GitRaka/ESD_Semester_Project/Schematics/PowerBoard/Buck-Boost Power Board/Project Outputs for Buck-Boost Power Board/PDF/DRC/Design Rules Check.PDF

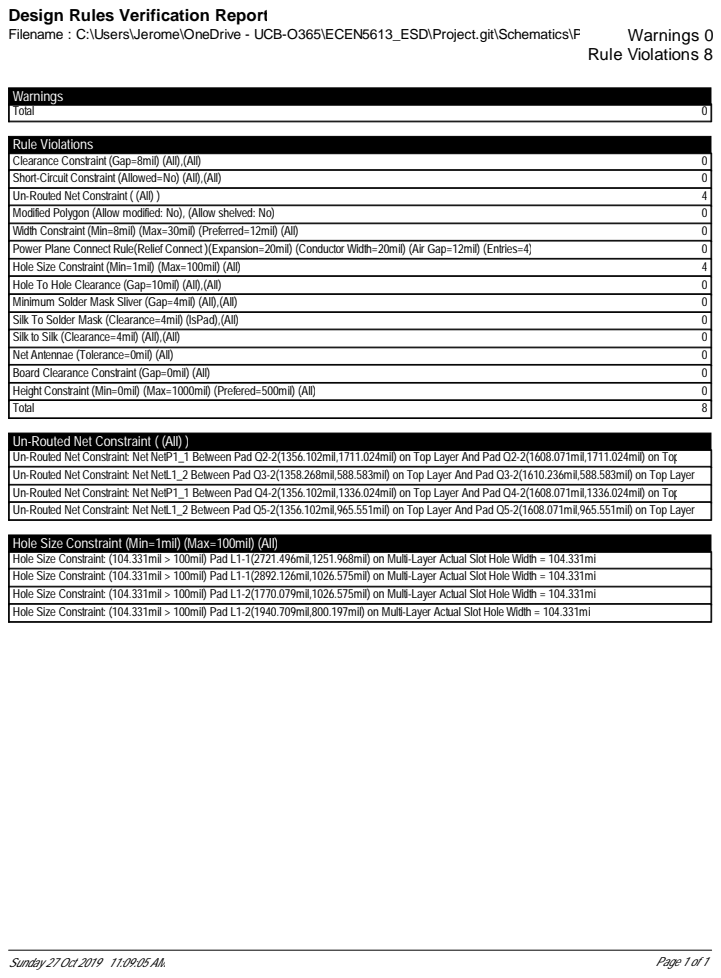
[picture p5: page 1]

Design Rules Verification Report

Un-Routed Net Constraint ( (All) )
Un-Routed Net Constraint: Net NetP1_1 Between Pad Q2-2(1356.102mil,1711.024mil) on Top Layer And Pad Q2-2(1608.071mil,1711.024mil) on Top
Un-Routed Net Constraint: Net NetL1_2 Between Pad Q3-2(1358.268mil,588.583mil) on Top Layer And Pad Q3-2(1610.236mil,588.583mil) on Top Layer
Un-Routed Net Constraint: Net NetP1_1 Between Pad Q4-2(1356.102mil,1336.024mil) on Top Layer And Pad Q4-2(1608.071mil,1336.024mil) on Top
Un-Routed Net Constraint: Net NetL1_2 Between Pad Q5-2(1356.102mil,965.551mil) on Top Layer And Pad Q5-2(1608.071mil,965.551mil) on Top Layer

Hole Size Constraint (Min=1mil) (Max=100mil) (All)
Hole Size Constraint: (104.331mil > 100mil) Pad L1-1(2721.496mil,1251.968mil) on Multi-Layer Actual Slot Hole Width = 104.331mi
Hole Size Constraint: (104.331mil > 100mil) Pad L1-1(2892.126mil,1026.575mil) on Multi-Layer Actual Slot Hole Width = 104.331mi
Hole Size Constraint: (104.331mil > 100mil) Pad L1-2(1770.079mil,1026.575mil) on Multi-Layer Actual Slot Hole Width = 104.331mi
Hole Size Constraint: (104.331mil > 100mil) Pad L1-2(1940.709mil,800.197mil) on Multi-Layer Actual Slot Hole Width = 104.331mi
