GitRaka/ESD_Semester_Project/Schematics/PowerBoard/Buck-Boost Power Board/Project Outputs for Buck-Boost Power Board/PDF/Schematic Print/Schematic Prints.PDF

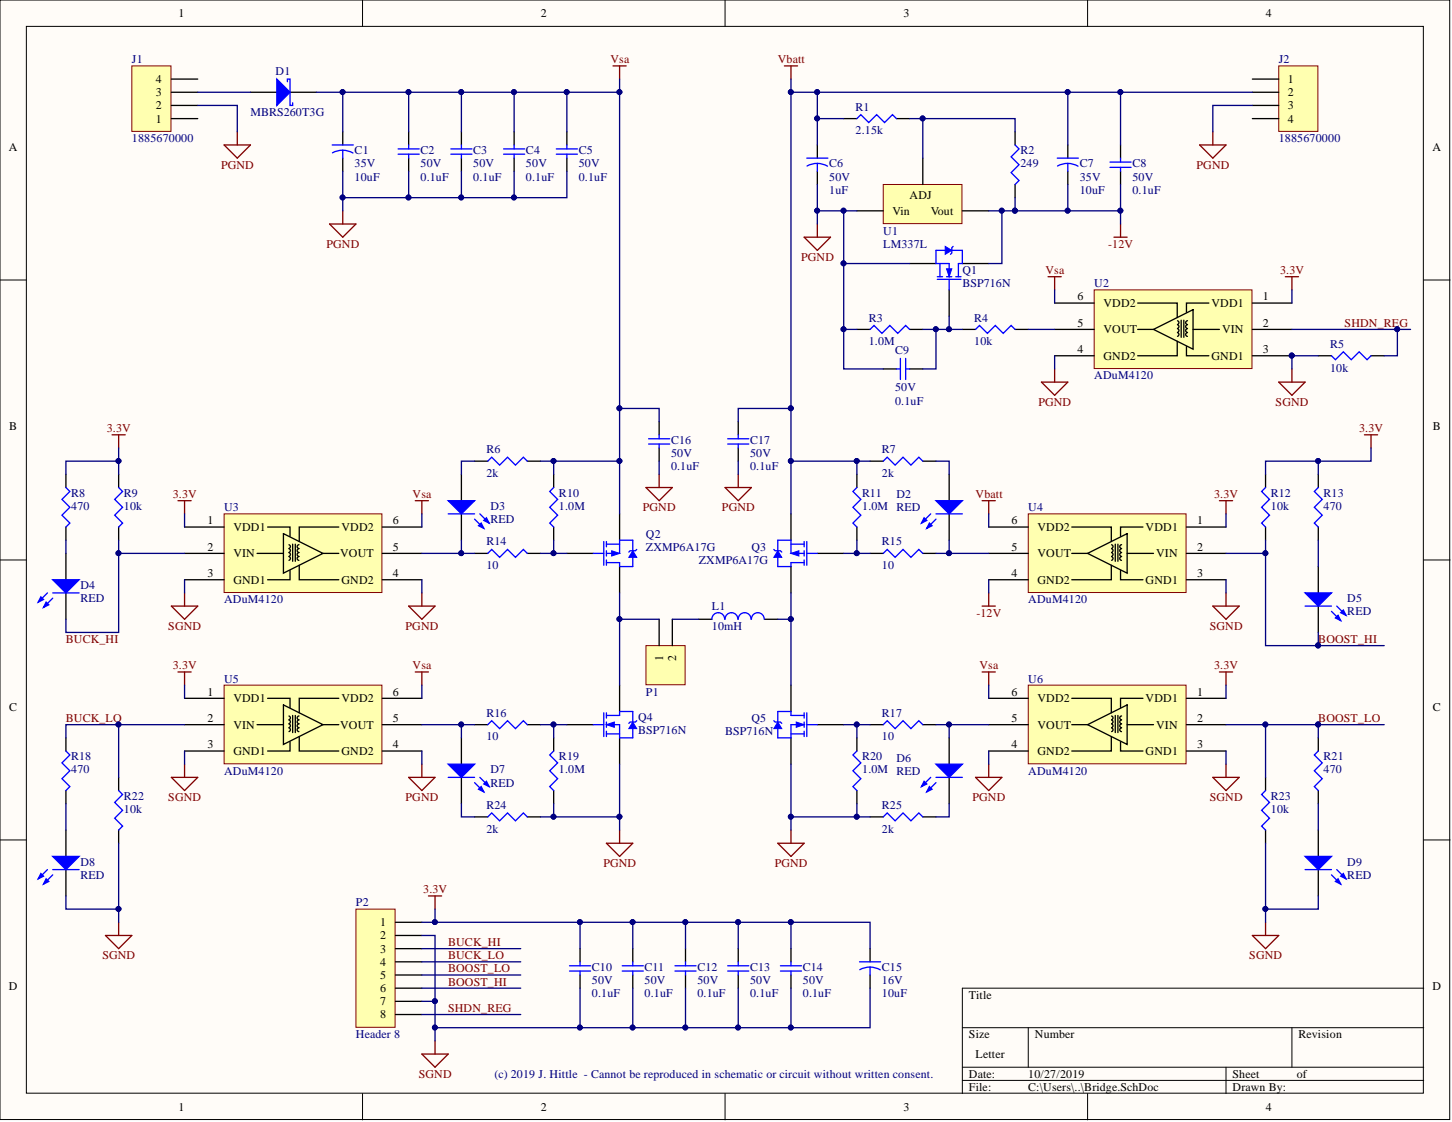
[picture p6: page 1]

(c) 2019 J. Hittle - Cannot be reproduced in schematic or circuit without written consent.
