GitRaka/ESD_Semester_Project/Schematics/PowerBoard/Buck-Boost Power Board/Project Outputs for Buck-Boost Power Board/PDF/PCB Print/Assembly Drawings.PDF

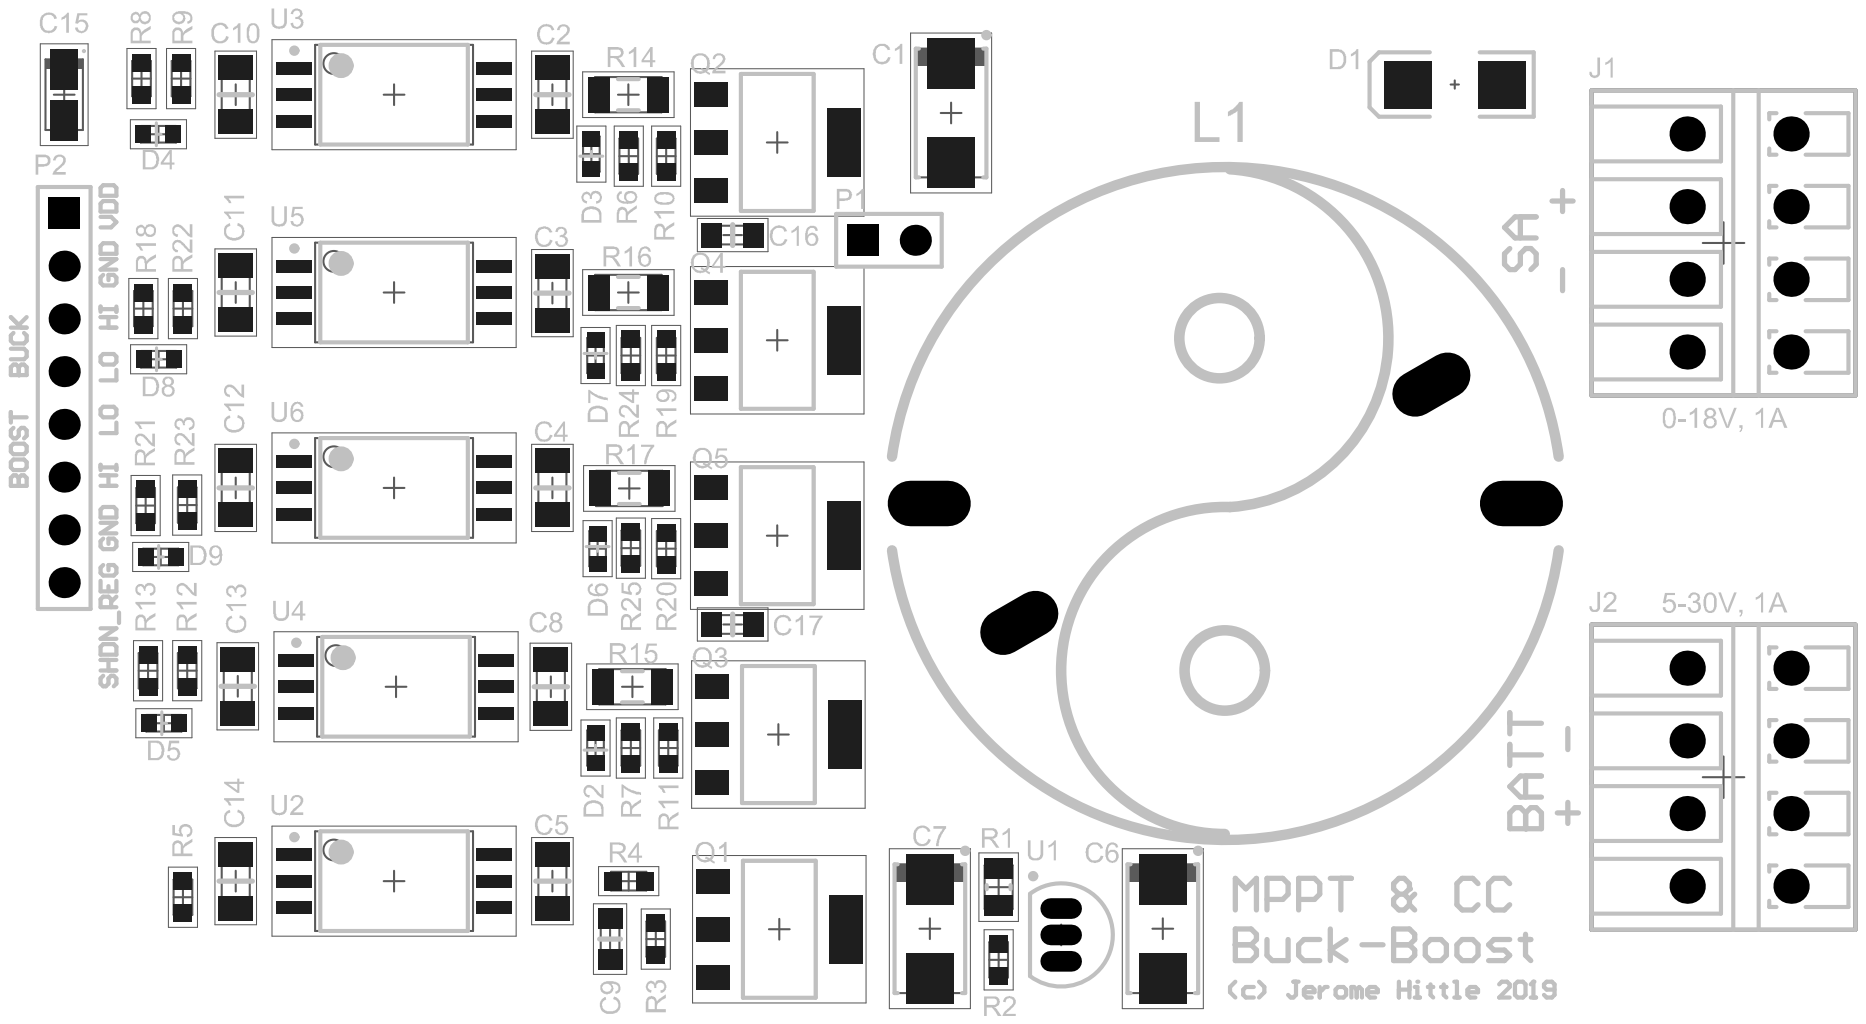
[picture p7: page 1]

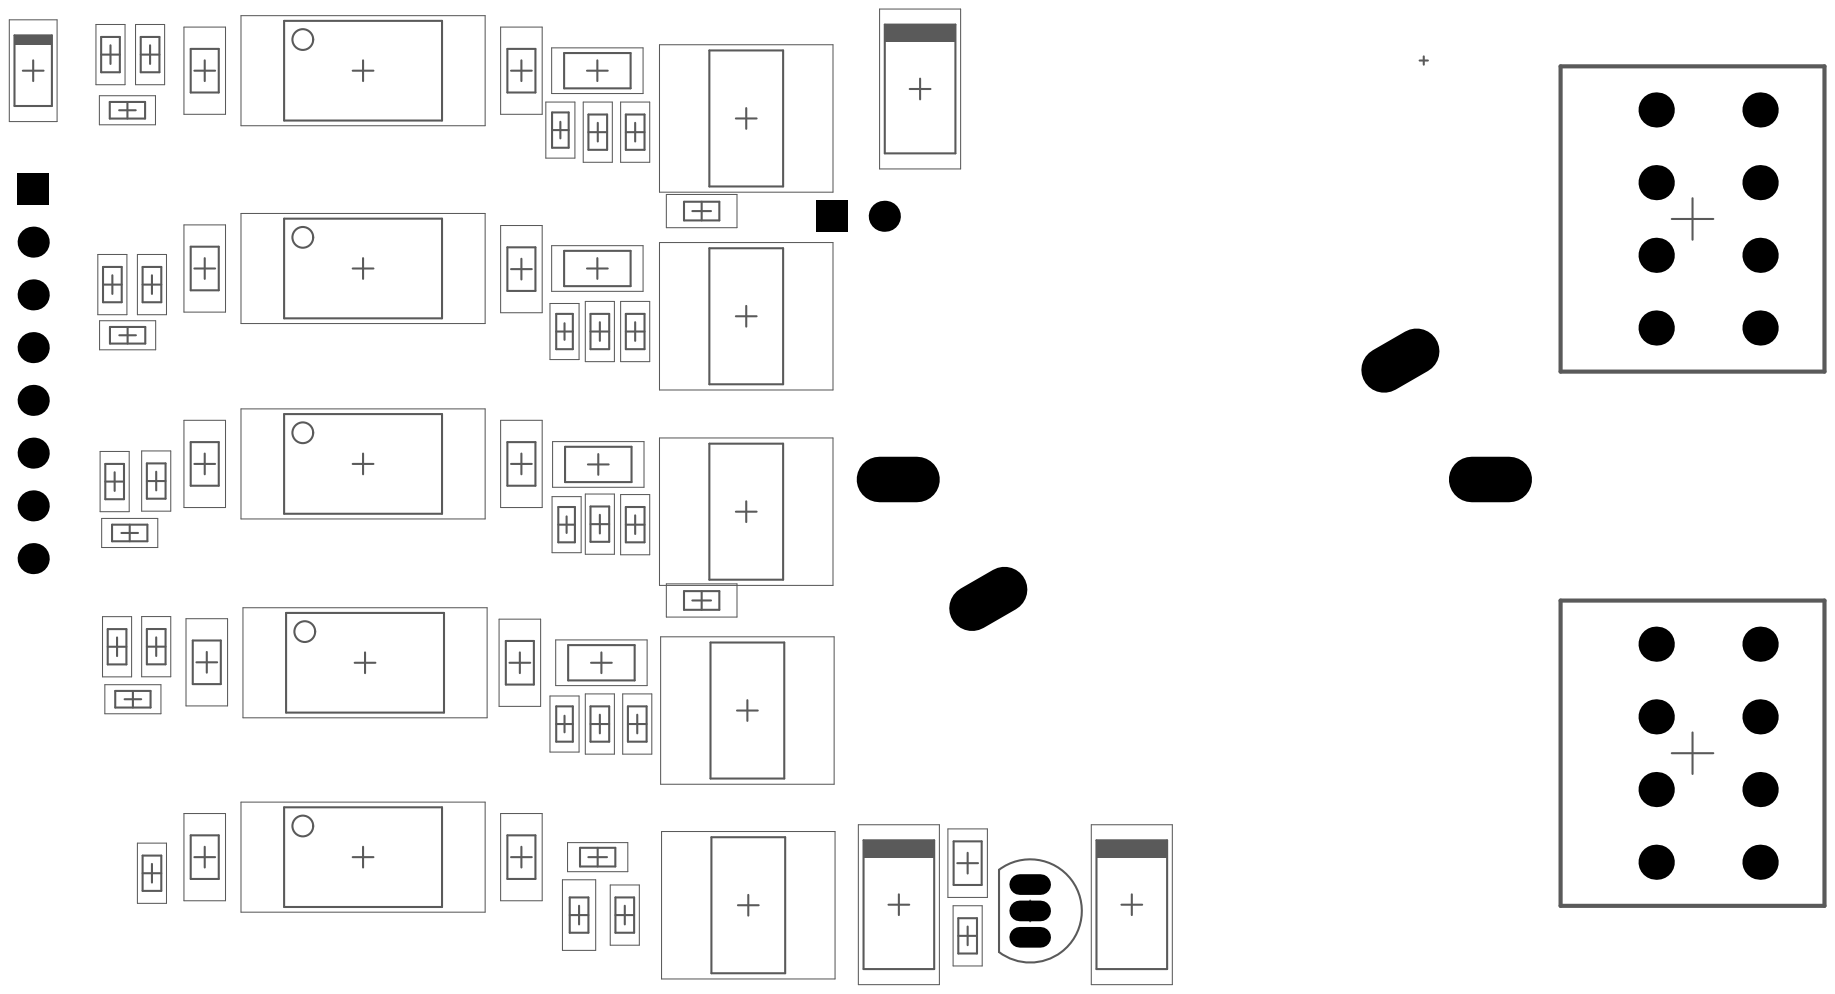
[picture p8: page 2]
