GitRaka/ESD_Semester_Project/(list of files, drawings)

Other design files:
Schematics/altiumlibs/Connectors.PcbLib
Schematics/altiumlibs/Connectors.SchLib
Schematics/altiumlibs/Generic Devices.PcbLib
Schematics/altiumlibs/Generic Devices.SchLib
Schematics/altiumlibs/Specific Devices.PcbLib
Schematics/altiumlibs/Specific Devices.SchLib
Schematics/PowerBoard/Buck-Boost Power Board/Bridge.SchDoc
Schematics/PowerBoard/Buck-Boost Power Board/Buck-Boost Power Board.PrjPcb
Schematics/PowerBoard/Buck-Boost Power Board/BuckBoostPCB.PcbDoc
