GitRaka/ESD_Semester_Project/Software/ESDFinalProject/powerPWM.c

/*
 * Name: powerPWM.c
 * Author: Jerome Hittle
 * Tools Used: Code Composer Studio 9.2.0
 * Leveraged Code:  timer_a_updown_compare_multiple_pwm.c
 * Links:
 *
 * (c) j. hittle 2019 - All rights reserved.
 * This file may not be reused, shared, or copied without written permission
 *   of the author for any reason, except where applicable by law.  The
 *   author retains all rights to the intellectual property herein.
 */

/* --COPYRIGHT--,BSD
 * Copyright (c) 2017, Texas Instruments Incorporated
 * All rights reserved.
 *
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
 * *  Redistributions of source code must retain the above copyright
 *    notice, this list of conditions and the following disclaimer.
 *
 * *  Redistributions in binary form must reproduce the above copyright
 *    notice, this list of conditions and the following disclaimer in the
 *    documentation and/or other materials provided with the distribution.
 *
 * *  Neither the name of Texas Instruments Incorporated nor the names of
 *    its contributors may be used to endorse or promote products derived
 *    from this software without specific prior written permission.
 *
 * THIS SOFTWARE IS PROVIDED BY THE COPYRIGHT HOLDERS AND CONTRIBUTORS "AS IS"
 * AND ANY EXPRESS OR IMPLIED WARRANTIES, INCLUDING, BUT NOT LIMITED TO,
 * THE IMPLIED WARRANTIES OF MERCHANTABILITY AND FITNESS FOR A PARTICULAR
 * PURPOSE ARE DISCLAIMED. IN NO EVENT SHALL THE COPYRIGHT OWNER OR
 * CONTRIBUTORS BE LIABLE FOR ANY DIRECT, INDIRECT, INCIDENTAL, SPECIAL,
 * EXEMPLARY, OR CONSEQUENTIAL DAMAGES (INCLUDING, BUT NOT LIMITED TO,
 * PROCUREMENT OF SUBSTITUTE GOODS OR SERVICES; LOSS OF USE, DATA, OR PROFITS;
 * OR BUSINESS INTERRUPTION) HOWEVER CAUSED AND ON ANY THEORY OF LIABILITY,
 * WHETHER IN CONTRACT, STRICT LIABILITY, OR TORT (INCLUDING NEGLIGENCE OR
 * OTHERWISE) ARISING IN ANY WAY OUT OF THE USE OF THIS SOFTWARE,
 * EVEN IF ADVISED OF THE POSSIBILITY OF SUCH DAMAGE.
 * --/COPYRIGHT--*/
/* **************************************************************************** */

/* DriverLib Includes */
#include <ti/devices/msp432p4xx/driverlib/driverlib.h>

/* Standard Includes */
#include <stdint.h>
#include <stdbool.h>
#include "powerPWM.h"
#include "adc.h"

/* Externally available variables*/
/* Name: changeDutyCycleFlag
 * Use: Indicates that it is time to change the PWM duty cycle because the number
 *      of switching cycles has exceeded CYCLE_COUNT_MAX.  Must be cleared by
 *      external software.
 */
volatile bool changeDutyCycleFlag = true;

#define CLOSED_LOOP     //Specifies closed loop operation, comment out to define open
                        //  loop operation

/* Application Defines */
#define TIMER_PERIOD            1200                                //count of 1200 = period of 50us or 20kHz
#define DEADTIME                50                                  //Deadtime count of 50 = 1us on the front and back end, 2us total.
#ifdef CLOSED_LOOP
#define STARTING_DUTY_CYCLE     0.1                                 //starting duty cycle
#else
#define STARTING_DUTY_CYCLE     0.7                                 //starting duty cycle
#endif
#define CYCLE_COUNT_MAX         10                                  //Number of cycles between actions (adjusting output voltage, current, etc)

#define DEADTIME                50                                  //1us deadtime on both sides.
#define DUTY_CYCLE_N            (TIMER_PERIOD - (TIMER_PERIOD * STARTING_DUTY_CYCLE)) //duty cycle to start
#define DUTY_CYCLE_P            (DUTY_CYCLE_N - DEADTIME)

#define NMOS_HARD_OFF           TIMER_PERIOD
#define NMOS_HARD_ON            0
#define PMOS_HARD_OFF           0
#define PMOS_HARD_ON            TIMER_PERIOD

/* local variables */
bool powerSupplyOffFlag = true;

/* Timer_A UpDown Configuration Parameter */
Timer_A_UpDownModeConfig upDownConfig =
{
        TIMER_A_CLOCKSOURCE_SMCLK,              // SMCLK Clock SOurce
        TIMER_A_CLOCKSOURCE_DIVIDER_1,          // SMCLK/1 = 48MHz
        TIMER_PERIOD,                           // tick period
        TIMER_A_TAIE_INTERRUPT_DISABLE,         // Disable Timer interrupt
        TIMER_A_CCIE_CCR0_INTERRUPT_DISABLE,    // Disable CCR0 interrupt
        TIMER_A_DO_CLEAR                        // Clear value

};

/* Timer_A Compare Configuration Parameter  (PWM1) */
/* Control for Boost NMOS Switch */
Timer_A_CompareModeConfig compareConfig_PWM1 =
{
        TIMER_A_CAPTURECOMPARE_REGISTER_1,          // Use CCR1
        TIMER_A_CAPTURECOMPARE_INTERRUPT_DISABLE,   // Disable CCR interrupt
        TIMER_A_OUTPUTMODE_TOGGLE_SET,              // Toggle output
        //DUTY_CYCLE_N
        NMOS_HARD_OFF                               // Initialize N-channel as always off
};

/* Timer_A Compare Configuration Parameter (PWM2) */
/* Control for Boost PMOS Switch */
Timer_A_CompareModeConfig compareConfig_PWM2 =
{
        TIMER_A_CAPTURECOMPARE_REGISTER_2,          // Use CCR2
        TIMER_A_CAPTURECOMPARE_INTERRUPT_DISABLE,   // Disable CCR interrupt
        TIMER_A_OUTPUTMODE_TOGGLE_SET,              // Toggle output
        //DUTY_CYCLE_P
        PMOS_HARD_OFF                               // Initialize P-channel as always off
};

/* Timer_A Compare Configuration Parameter (PWM3) */
/* Control for Buck NMOS Switch */
Timer_A_CompareModeConfig compareConfig_PWM3 =
{
        TIMER_A_CAPTURECOMPARE_REGISTER_3,          // Use CCR3
        TIMER_A_CAPTURECOMPARE_INTERRUPT_DISABLE,   // Disable CCR interrupt
        TIMER_A_OUTPUTMODE_TOGGLE_SET,              // Toggle output
        //TIMER_PERIOD
        NMOS_HARD_OFF                               // Initialize N-channel as always off
};

/* Timer_A Compare Configuration Parameter (PWM4) */
/* Control for Buck PMOS Switch */
const Timer_A_CompareModeConfig compareConfig_PWM4 =
{
        TIMER_A_CAPTURECOMPARE_REGISTER_4,          // Use CCR4
        TIMER_A_CAPTURECOMPARE_INTERRUPT_DISABLE,   // Disable CCR interrupt
        TIMER_A_OUTPUTMODE_TOGGLE_SET,              // Toggle output
        PMOS_HARD_OFF                               // Initialize P-channel as always off
};



void initPowerPWM(void) {

    /* Configuring GPIO2.4 as peripheral output for PWM  and P6.7 for button
     * interrupt */
    MAP_GPIO_setAsPeripheralModuleFunctionOutputPin(GPIO_PORT_P2, \
                                                GPIO_PIN4 | GPIO_PIN5 | GPIO_PIN6 | GPIO_PIN7, \
                                                GPIO_PRIMARY_MODULE_FUNCTION);

    /* Configuring Timer_A to have a period of approximately 500ms and
     * an initial duty cycle of 10% of that (3200 ticks)  */
    MAP_Timer_A_configureUpDownMode(TIMER_A0_BASE, &upDownConfig);
    MAP_Timer_A_startCounter(TIMER_A0_BASE, TIMER_A_UPDOWN_MODE);

    /* Initialize compare registers to generate PWM1 */
    MAP_Timer_A_initCompare(TIMER_A0_BASE, &compareConfig_PWM1);
    MAP_Timer_A_initCompare(TIMER_A0_BASE, &compareConfig_PWM2);
    MAP_Timer_A_initCompare(TIMER_A0_BASE, &compareConfig_PWM3);
    MAP_Timer_A_initCompare(TIMER_A0_BASE, &compareConfig_PWM4);

    MAP_Timer_A_enableCaptureCompareInterrupt(TIMER_A0_BASE, TIMER_A_CAPTURECOMPARE_REGISTER_0);

    MAP_Interrupt_enableInterrupt(INT_TA0_0);       //Interrupt when the count up-down timer reaches its peak
}

void turnOffPowerSupply (void) {
    TA0CCR1 = NMOS_HARD_OFF;                    //Adjust nMOS capture compare register directly
    TA0CCR2 = PMOS_HARD_OFF;                    //Adjust pMOS capture compare register directly
    TA0CCR3 = NMOS_HARD_OFF;                    //Ensure Buck nMOS is OFF
    TA0CCR4 = PMOS_HARD_OFF;                    //Ensure Buck pMOS is OFF

    powerSupplyOffFlag = true;
}

void passMode (void) {
    TA0CCR1 = NMOS_HARD_OFF;                    //Adjust nMOS capture compare register directly
    TA0CCR2 = PMOS_HARD_ON;                    //Adjust pMOS capture compare register directly
    TA0CCR3 = NMOS_HARD_OFF;                    //Ensure Buck nMOS is OFF
    TA0CCR4 = PMOS_HARD_ON;                    //Ensure Buck pMOS is OFF
}

uint16_t decrementBoostDutyCycle(void) {
#ifdef CLOSED_LOOP
    if (TA0CCR1 < TIMER_PERIOD) {  //Don't set to higher values than appropriate
        //Incrementing the CC registers reduces the time that the pair of nMOS/pMOS
        //  is driving the switching node low - in this way, it's actually decrementing
        //  the duty cycle by incrementing the count level
        TA0CCR1 += 1;                           //Adjust nMOS capture compare register directly
        TA0CCR2 = TA0CCR1 - DEADTIME;           //Adjust pMOS capture compare register directly
        TA0CCR3 = NMOS_HARD_OFF;                //Ensure Buck nMOS is OFF
        TA0CCR4 = PMOS_HARD_ON;                 //Ensure Buck pMOS is ON
    }
#endif
    // Set P10.0 high to indicate Boost duty cycle is being decremented
    MAP_GPIO_setOutputHighOnPin(GPIO_PORT_P10, GPIO_PIN0);
    MAP_GPIO_setOutputLowOnPin(GPIO_PORT_P10, GPIO_PIN1 | GPIO_PIN3 | GPIO_PIN4 );

    return ( TIMER_PERIOD - TA0CCR1 );
}

void incrementBoostDutyCycle(void) {
#ifdef CLOSED_LOOP
    if ( TA0CCR2 > 0 | powerSupplyOffFlag ) {      //Minimum Pulse Width
        //Decrementing the CC registers increases the time that the pair of nMOS/pMOS
        //  is driving the switching node low - in this way, it's actually incrementing
        //  the duty cycle by decrementing the count level
        TA0CCR2 = TA0CCR1 - DEADTIME - 1;       //Adjust pMOS capture compare register directly
        TA0CCR1 -= 1;                           //Adjust nMOS capture compare register directly
        TA0CCR3 = NMOS_HARD_OFF;                //Ensure Buck nMOS is OFF
        TA0CCR4 = PMOS_HARD_ON;                 //Ensure Buck pMOS is ON

        powerSupplyOffFlag = false;
    }
#endif
    // Set P10.1 high to indicate Boost duty cycle is being incremented
    MAP_GPIO_setOutputHighOnPin(GPIO_PORT_P10, GPIO_PIN1);
    MAP_GPIO_setOutputLowOnPin(GPIO_PORT_P10, GPIO_PIN0 | GPIO_PIN2 | GPIO_PIN3 );
}


uint16_t decrementBuckDutyCycle(void) {
#ifdef CLOSED_LOOP
    if (  TA0CCR3 < TIMER_PERIOD  ) {      //Minimum Pulse Width
        //Decrementing the CC registers increases the time that the pair of nMOS/pMOS
        //  is driving the switching node low - in this way, it's actually incrementing
        //  the duty cycle by decrementing the count level

        TA0CCR3 += 1;                          //Adjust nMOS capture compare register directly
        TA0CCR4 = TA0CCR3 - DEADTIME;          //Adjust pMOS capture compare register directly
        TA0CCR1 = NMOS_HARD_OFF;               //Make sure Boost nMOS is OFF
        TA0CCR2 = PMOS_HARD_ON;                //Make sure Boost pMOS is ON
    } else if (powerSupplyOffFlag) {
        //Note this is handled differently than in the boost case to startup because
        //  the duty cycle needs to count up!
        //  Need to kickstart the power supply by incrementing the duty cycle!
        incrementBuckDutyCycle();
    }
#endif
    // Set P10.2 high to indicate Boost duty cycle is being incremented
    MAP_GPIO_setOutputHighOnPin(GPIO_PORT_P10, GPIO_PIN2);
    MAP_GPIO_setOutputLowOnPin(GPIO_PORT_P10, GPIO_PIN0 | GPIO_PIN1 | GPIO_PIN3);

    return ( TIMER_PERIOD - TA0CCR3 );
}

void incrementBuckDutyCycle(void) {
#ifdef CLOSED_LOOP
    if (TA0CCR4 > 0 | powerSupplyOffFlag ) {      //Minimum Pulse Width
        //Decrementing the CC registers increases the time that the pair of nMOS/pMOS
        //  is driving the switching node low - in this way, it's actually incrementing
        //  the duty cycle by decrementing the count level

        TA0CCR4 = TA0CCR3 - DEADTIME - 1;      //Adjust pMOS capture compare register directly
        TA0CCR3 -= 1;                          //Adjust nMOS capture compare register directly
        TA0CCR1 = NMOS_HARD_OFF;               //Make sure Boost nMOS is OFF
        TA0CCR2 = PMOS_HARD_ON;                //Make sure Boost pMOS is ON


    }
#endif
    // Set P10.3 high to indicate Boost duty cycle is being incremented
    MAP_GPIO_setOutputHighOnPin(GPIO_PORT_P10, GPIO_PIN3);
    MAP_GPIO_setOutputLowOnPin(GPIO_PORT_P10, GPIO_PIN0 | GPIO_PIN1 | GPIO_PIN2);

    powerSupplyOffFlag = false;


}

void TA0_0_IRQHandler(void) {
    static uint8_t cycleCount = 0;

    // Toggle P10.4 to indicate TA0 IRQ entered
    MAP_GPIO_toggleOutputOnPin(GPIO_PORT_P10, GPIO_PIN4);

    if (++cycleCount == CYCLE_COUNT_MAX) {
        changeDutyCycleFlag = true;        //CYCLE_COUNT_MAX cycles has happened, time to change duty cycle
        cycleCount = 0;
    }

    startADCCapture();          //Very important that this is the only place starting an ADC capture is performed
                                //      to keep sync

    MAP_Timer_A_clearCaptureCompareInterrupt(TIMER_A0_BASE,
        TIMER_A_CAPTURECOMPARE_REGISTER_0);

}
