GitRaka/ESD_Semester_Project/(commit log)

2019-10-23 Adding Altium project and libraries
    [Buck-Boost Power Board.PrjPcb]
2019-10-25 Commiting project with completed schematic and BOM. About to start PCB build.
    [Bridge.SchDoc, Buck-Boost Power Board.PrjPcb]
2019-10-25 adding altium libraries used in this project. Also note that the default altium libraries are also used in this project
    [Connectors.PcbLib, Connectors.SchLib, Generic Devices.PcbLib, Generic Devices.SchLib, Specific Devices.PcbLib, Specific Devices.SchLib]
2019-10-25 Committing board part placement 90% complete
    [Bridge.SchDoc, BuckBoostPCB.PcbDoc]
2019-10-27 Commiting the first rev of the board before making output files
    [Bridge.SchDoc, Buck-Boost Power Board.PrjPcb, BuckBoostPCB.PcbDoc]
2019-10-27 Generated Project Outputs
    [Buck-Boost Power Board.PrjPcb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]
2019-10-27 Commit version submitted to pcbway
    [BuckBoostPCB.GBL, BuckBoostPCB.GBP, BuckBoostPCB.GBS, BuckBoostPCB.GM1, BuckBoostPCB.GTL, BuckBoostPCB.GTO, BuckBoostPCB.GTP, BuckBoostPCB.GTS]
2019-10-27 Updated to include drill files in submitted files
    [BuckBoostPCB.PcbDoc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]
2019-10-29 Commiting xlsx version of BOM
    [BOM.xlsx]
2019-11-22 Committing an initial program to the repository. Program uses HFXTAL to set a 2Hz blink on P1.0 and a simple PWM strobe on P2.4.
    [Calculations.xlsx]
2019-11-22 Got the initial PWM working at 20kHz
2019-11-24 Added adc measurements to measure the voltages on A6 thru A13. Measurements are made in sync with the power switching stage.
    [MSP432_Resourcing.xlsx]
2019-11-24 Got ADC feedback values to be accurate.
2019-11-24 Adding resourcing file
    [MSP432_Resourcing.xlsx]
2019-11-24 Successfully closed the loop around the Boostmode power supply
2019-12-06 started incorporating the buck power supply (after seeing the buck was working) and started blowing up ADC inputs on the MSP430! Storing this version off to the side until I can figure out what's hap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
2019-12-06 Got Buck working and transitioning from Buck to Boost and Back
2019-12-06 Successfully got Buck and Boost Modes working back and fourth with each other. And powering on into all three modes
